lewuq/IMU_Electronic_Ocean/3d/v1_ocean_rear_landscape_logo.stl

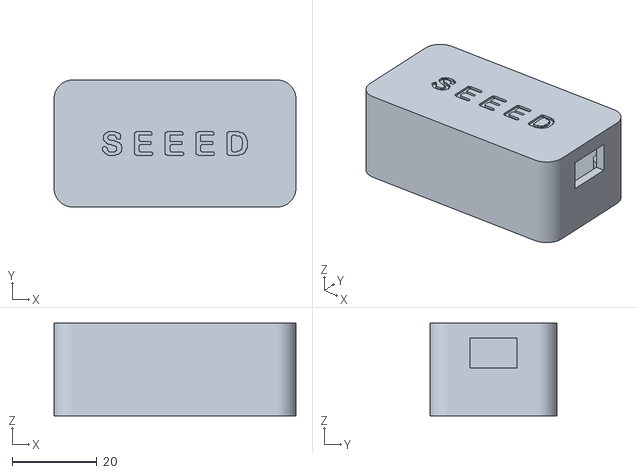
[picture p4: CAD file, 2026-11-02]
3d/v1_ocean_rear_landscape_logo.stl
57.0 x 30.0 x 21.8
