lewuq/IMU_Electronic_Ocean/3d/v2_ocean_front_42x14_landscape.stl

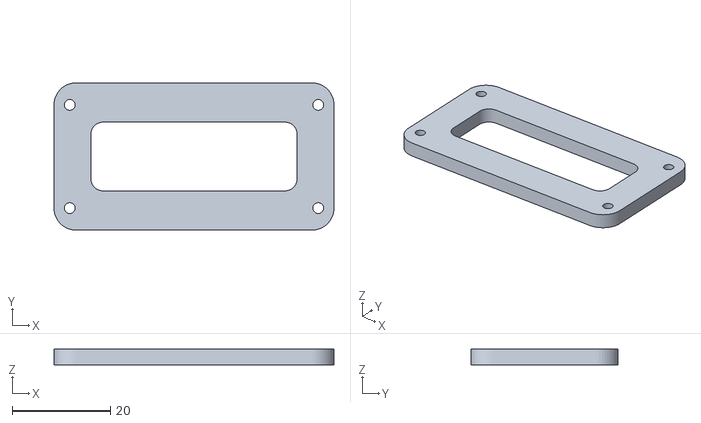
[picture p5: CAD file, 2026-11-02]
3d/v2_ocean_front_42x14_landscape.stl
57.0 x 30.0 x 3.20
