lewuq/IMU_Electronic_Ocean/(list of files, cad)

Other CAD files:
3d/v2_ocean_rear_landscape_AB.stl
3d/v1_ocean_front_42x14_landscape.stl
